ggbeauty989/lcd-deck/anteprima-fronte.png

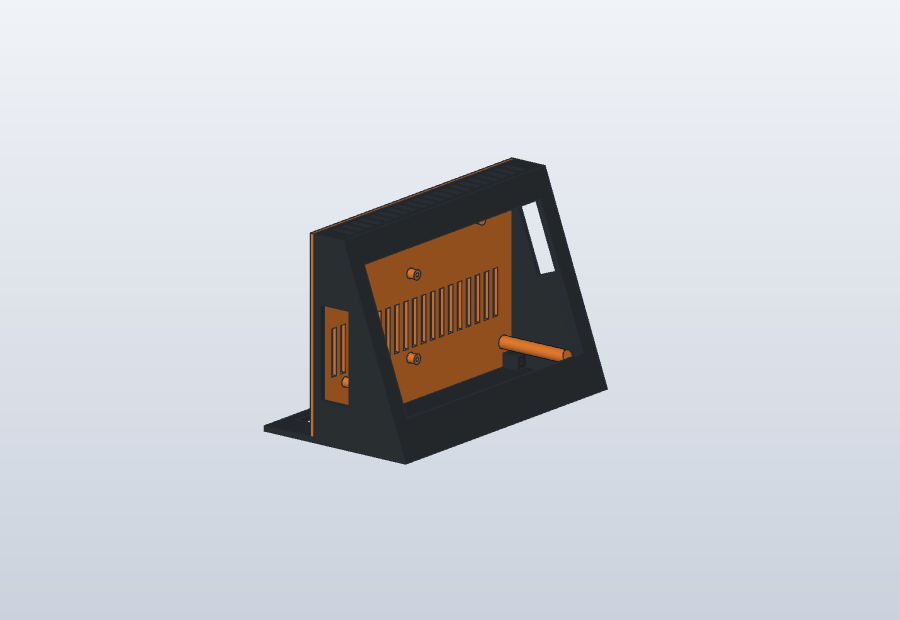
anteprima-fronte.png
