ggbeauty989/lcd-deck/anteprima-retro.png

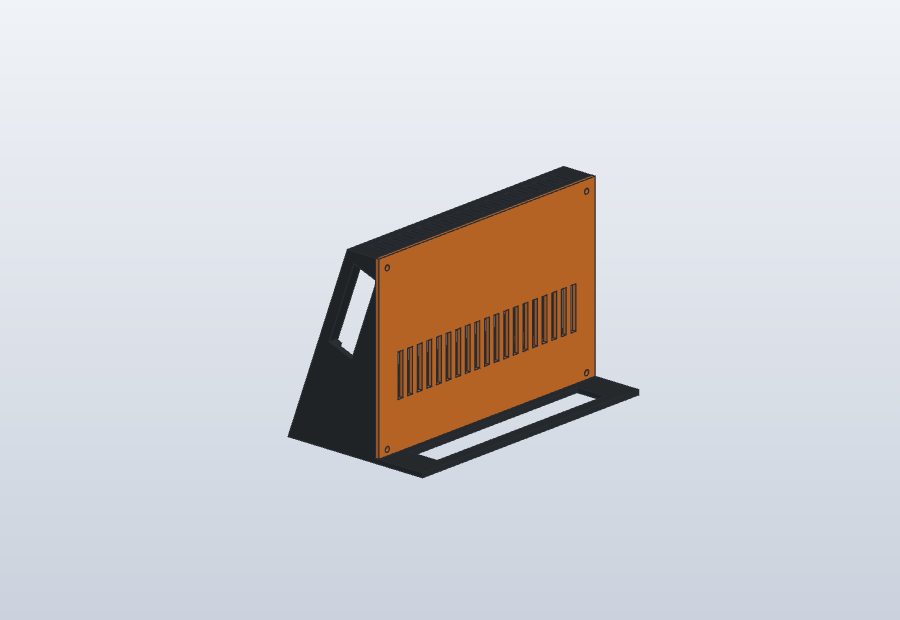
anteprima-retro.png
