ggbeauty989/lcd-deck/anteprima-v2-dettaglio.png

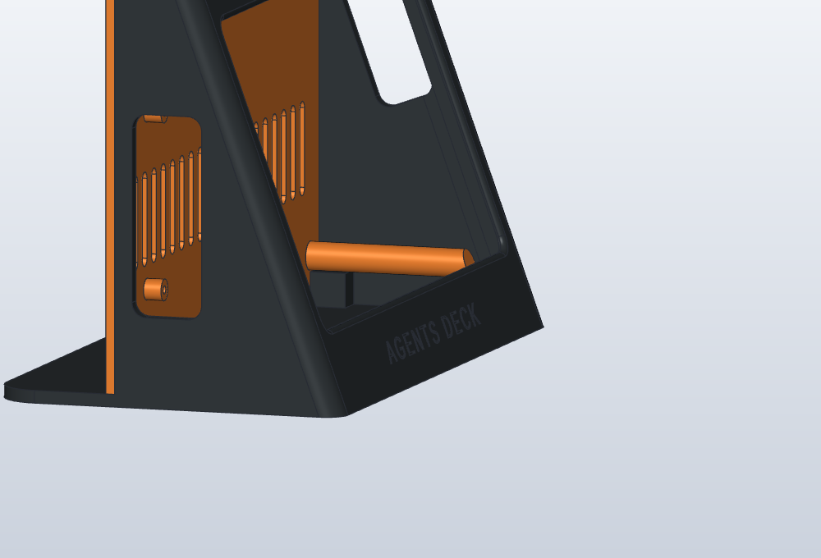
anteprima-v2-dettaglio.png
