ggbeauty989/lcd-deck/anteprima-v3-lato-usb.png

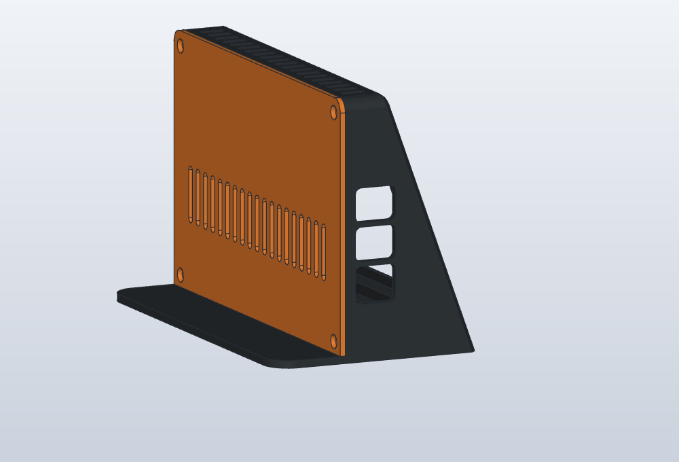
anteprima-v3-lato-usb.png
