ggbeauty989/lcd-deck/screenshot-componenti/02-fianco-sezione.png

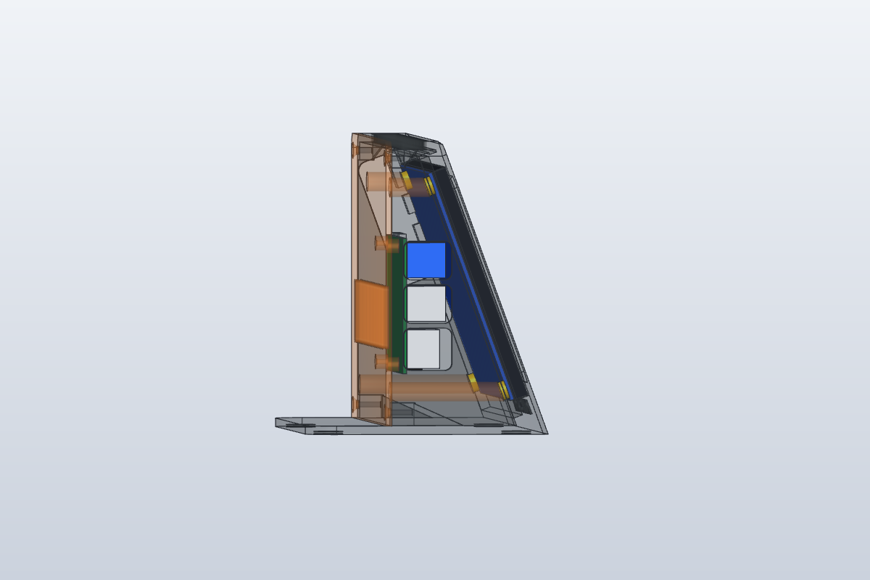
screenshot-componenti/02-fianco-sezione.png
