ggbeauty989/lcd-deck/screenshot-componenti/03-retro-trasparente.png

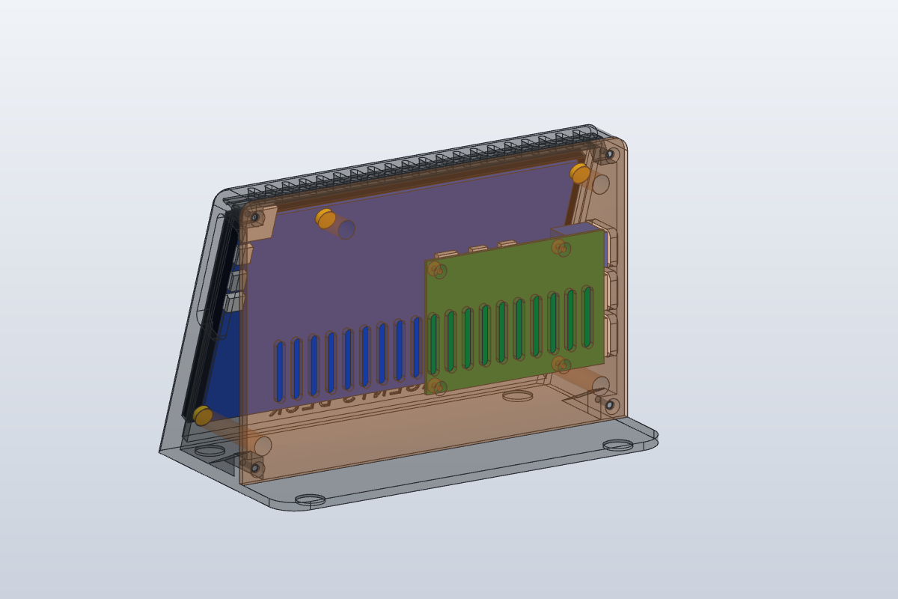
screenshot-componenti/03-retro-trasparente.png
