ggbeauty989/lcd-deck/screenshot-componenti/04-esploso-fronte.png

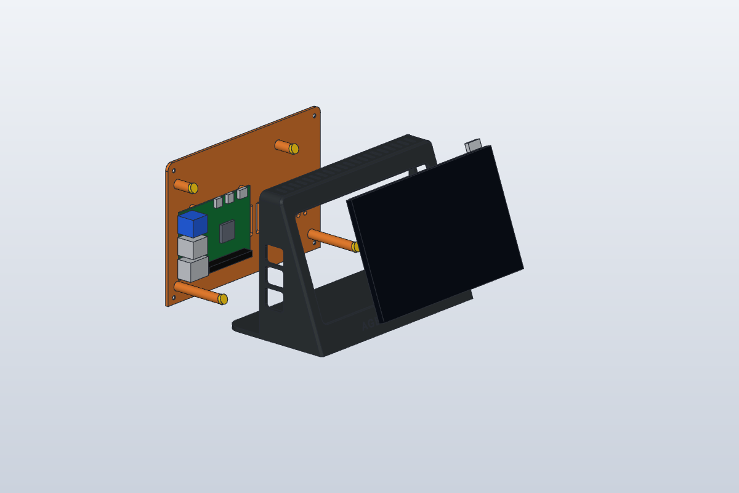
screenshot-componenti/04-esploso-fronte.png
