ggbeauty989/lcd-deck/screenshot-componenti/05-esploso-retro.png

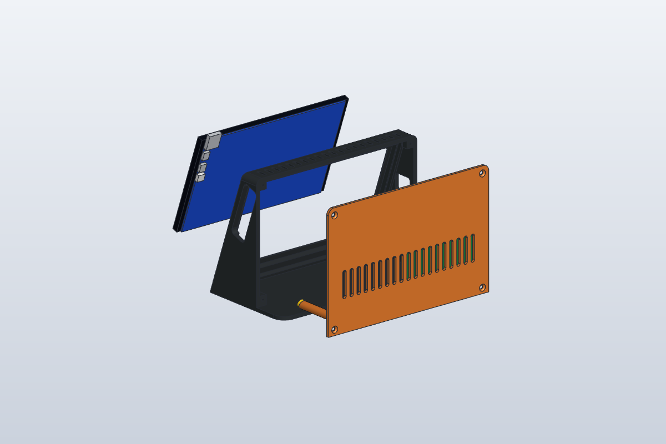
screenshot-componenti/05-esploso-retro.png
