ggbeauty989/lcd-deck/screenshot-modelli-reali/01-montato.png

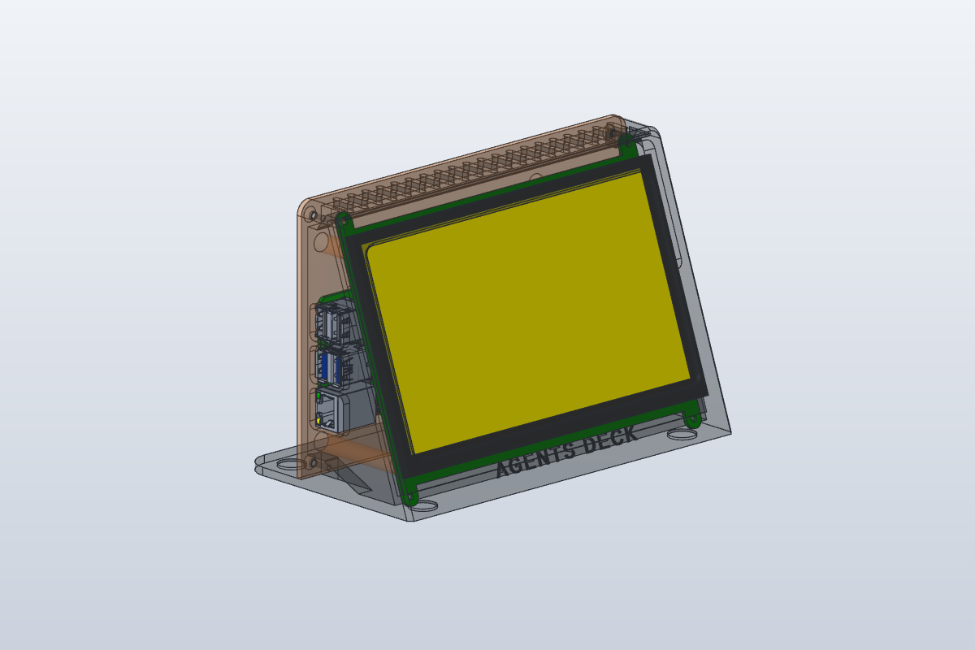
screenshot-modelli-reali/01-montato.png
