ggbeauty989/lcd-deck/screenshot-modelli-reali/03-porte-pi.png

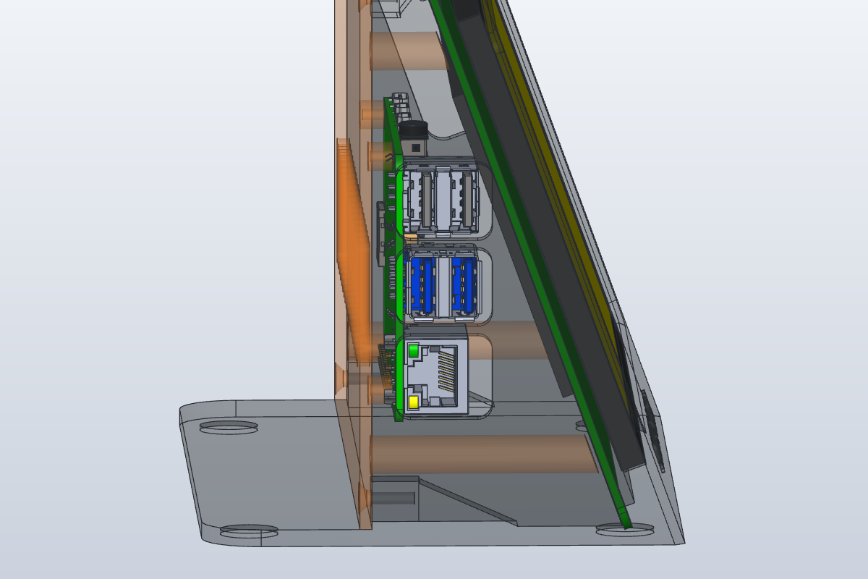
screenshot-modelli-reali/03-porte-pi.png
