ggbeauty989/lcd-deck/screenshot-modelli-reali/05-linguetta-nel-fondo.png

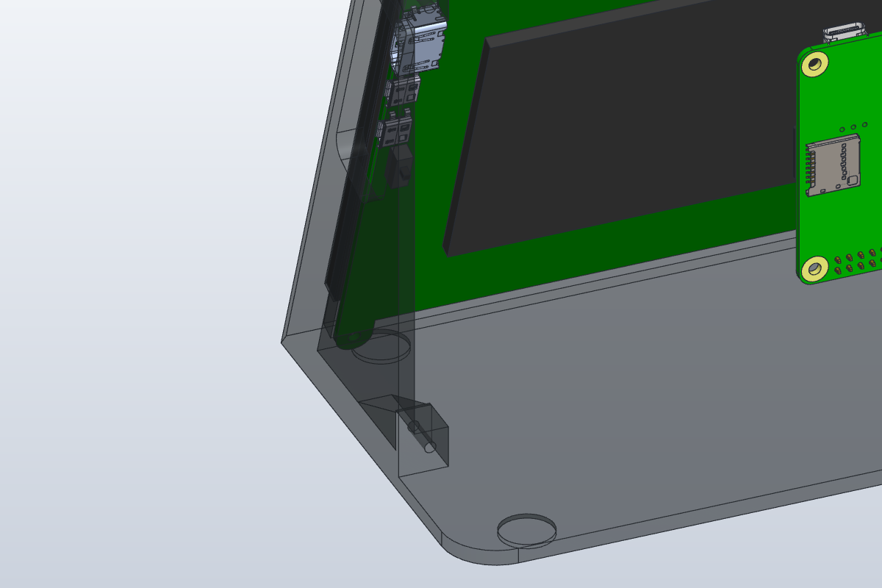
screenshot-modelli-reali/05-linguetta-nel-fondo.png
