ggbeauty989/lcd-deck/deck-v11-assieme.step

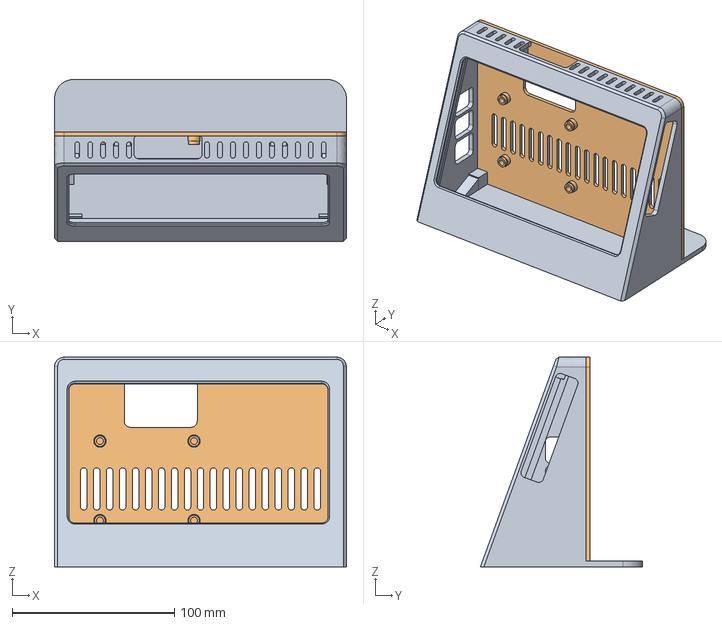
[picture p23: CAD file, 2026-10-25]
deck-v11-assieme.step
180.0 x 100.0 x 129.2 mm
