ggbeauty989/lcd-deck/deck-v11-scocca.stl

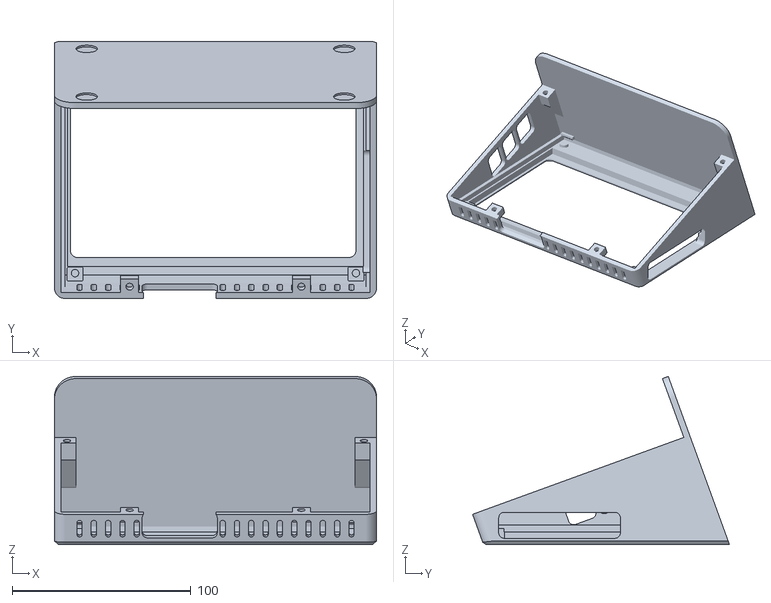
[picture p24: CAD file, 2026-10-25]
deck-v11-scocca.stl
180.0 x 143.6 x 94.0
