ggbeauty989/lcd-deck/deck-v11-coperchio.stl

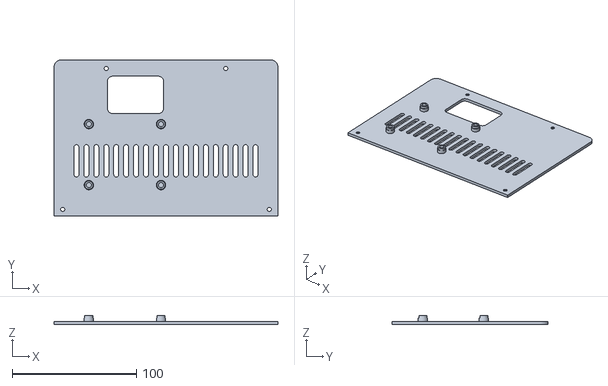
[picture p25: CAD file, 2026-10-25]
deck-v11-coperchio.stl
180.0 x 125.7 x 7.50
