ggbeauty989/lcd-deck/deck-kuman7-pi4-assieme.step

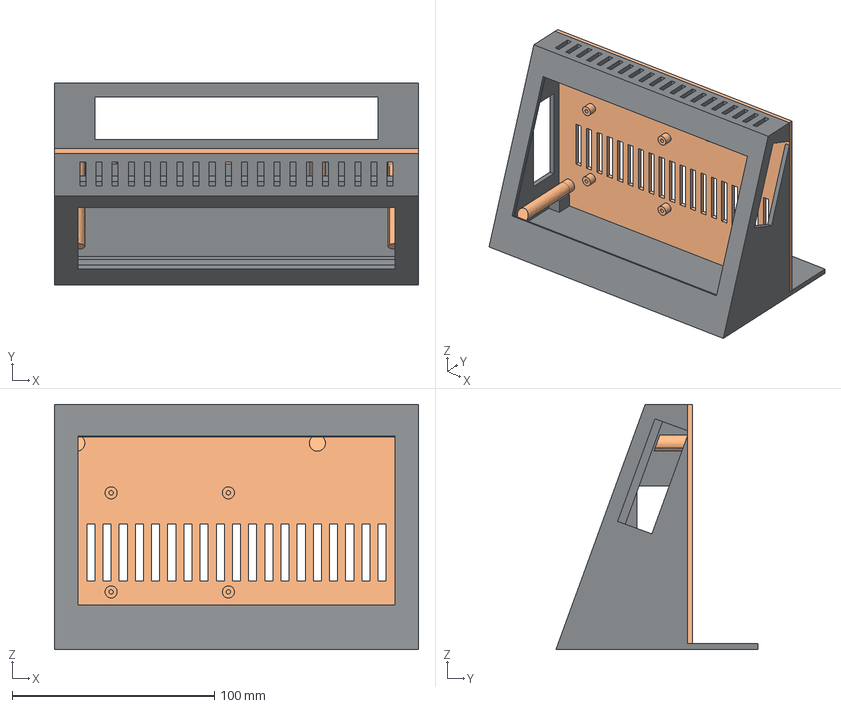
[picture p26: CAD file, 2026-10-24]
deck-kuman7-pi4-assieme.step
180.0 x 100.0 x 121.2 mm
