ggbeauty989/lcd-deck/old/v2/deck-v2-coperchio.stl

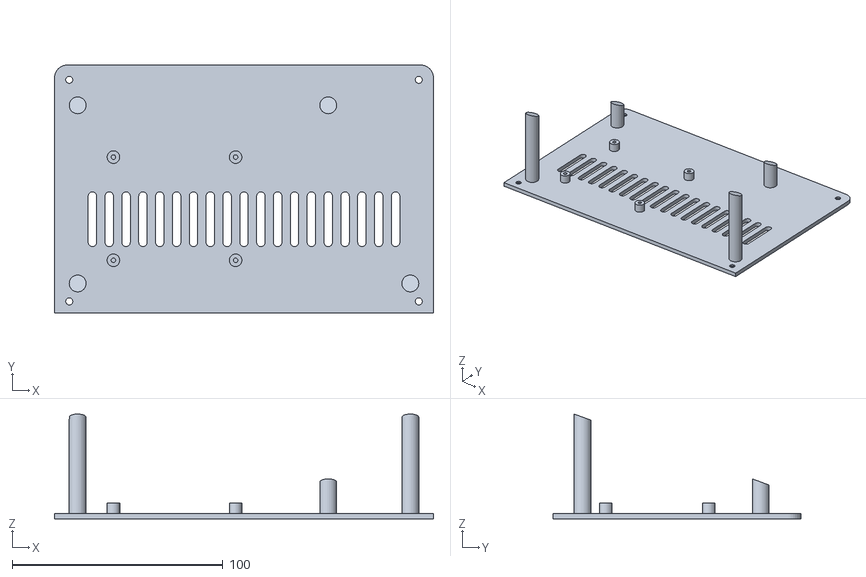
[picture p27: CAD file, 2026-10-24, an earlier design]
old/v2/deck-v2-coperchio.stl
180.0 x 117.7 x 49.8
