ggbeauty989/lcd-deck/old/v3/deck-v3-scocca.stl

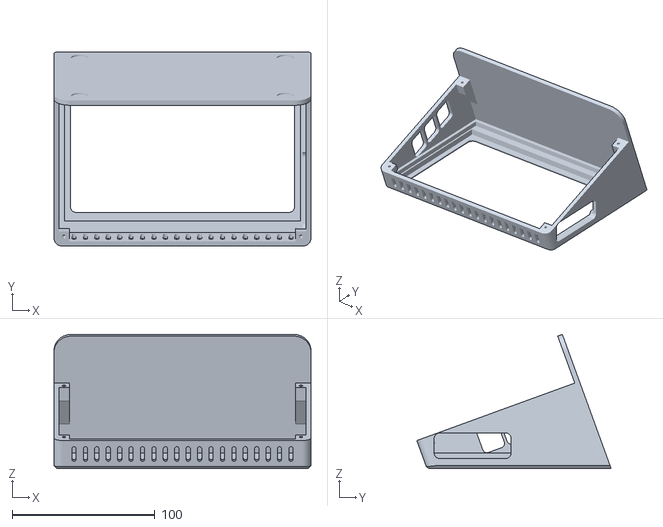
[picture p28: CAD file, 2026-10-24, an earlier design]
old/v3/deck-v3-scocca.stl
180.0 x 136.1 x 94.0
