ggbeauty989/lcd-deck/old/v4/deck-v4-coperchio.stl

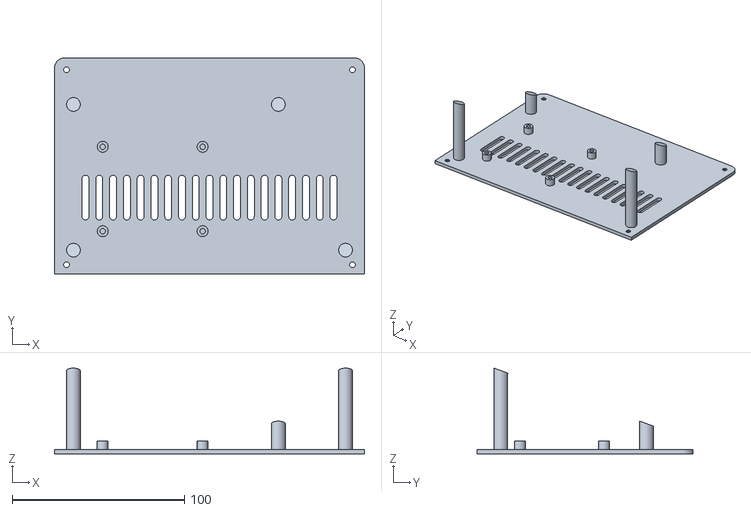
[picture p29: CAD file, 2026-10-24, an earlier design]
old/v4/deck-v4-coperchio.stl
180.0 x 125.7 x 49.8
