ggbeauty989/lcd-deck/old/v5/deck-v5-scocca.stl

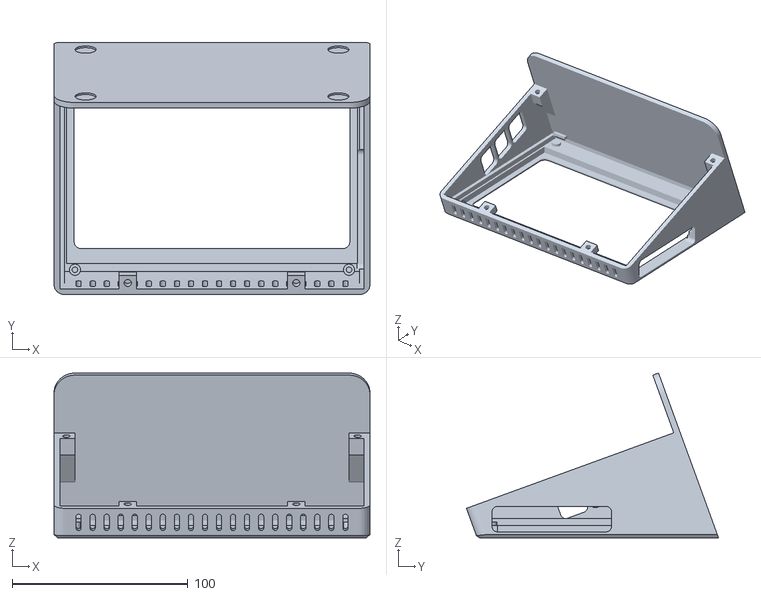
[picture p30: CAD file, 2026-10-24, an earlier design]
old/v5/deck-v5-scocca.stl
180.0 x 143.6 x 94.0
