ggbeauty989/lcd-deck/old/v7/deck-v7-assieme.step

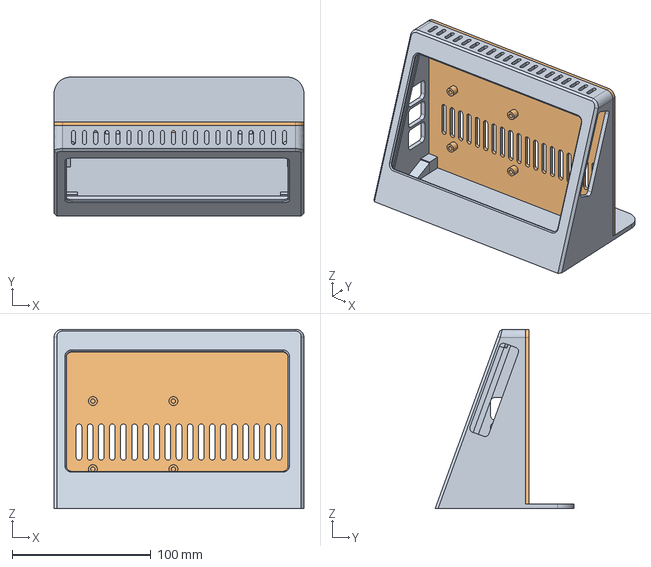
[picture p31: CAD file, 2026-10-25, an earlier design]
old/v7/deck-v7-assieme.step
180.0 x 100.0 x 129.2 mm
