ggbeauty989/lcd-deck/old/v2/deck-v2-assieme.step

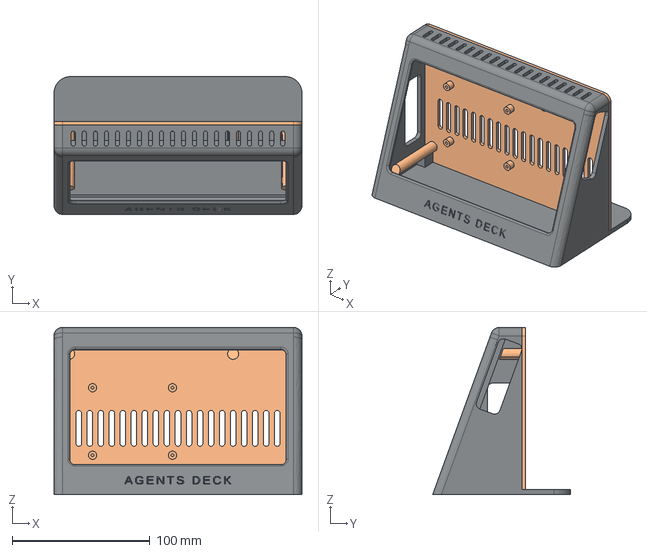
[picture p32: CAD file, 2026-10-24, an earlier design]
old/v2/deck-v2-assieme.step
180.0 x 100.0 x 121.2 mm
