ggbeauty989/lcd-deck/(list of files, cad)

Other CAD files:
old/v6/deck-v6-scocca.stl
old/v8/deck-v8-assieme.step
old/v9/deck-v9-assieme.step
old/v1/deck-coperchio.stl
old/v10/deck-v10-assieme.step
old/v3/deck-v3-assieme.step
deck-coperchio.stl
deck-scocca.stl
deck-v10-assieme.step
deck-v10-scocca.stl
deck-v2-scocca.stl
deck-v3-assieme.step
deck-v3-coperchio.stl
deck-v4-assieme.step
deck-v4-scocca.stl
deck-v5-assieme.step
deck-v6-assieme.step
deck-v6-scocca.stl
deck-v7-coperchio.stl
deck-v7-scocca.stl
deck-v8-assieme.step
deck-v8-coperchio.stl
deck-v9-assieme.step
deck-v9-coperchio.stl
old/v1/deck-scocca.stl
old/v10/deck-v10-scocca.stl
old/v2/deck-v2-scocca.stl
old/v3/deck-v3-coperchio.stl
old/v4/deck-v4-assieme.step
old/v4/deck-v4-scocca.stl
old/v5/deck-v5-assieme.step
old/v6/deck-v6-assieme.step
old/v7/deck-v7-coperchio.stl
old/v7/deck-v7-scocca.stl
old/v8/deck-v8-coperchio.stl
old/v9/deck-v9-coperchio.stl
