ggbeauty989/lcd-deck/(commit log)

2026-10-24 Deck da scrivania per LCD 7" e Raspberry Pi 4
    Supporto stampabile in 3D modellato con SolidCraft: corpo a cuneo
    inclinato di 20 gradi e coperchio posteriore con le colonnine del Pi.
    La v4 e' adattata al circuito con linguette dell'Elecrow/Kuman, ha i
    fori per inserti in ottone M3 e M2.5 e STL verificati a tenuta.
    Inclusi progetti SolidCraft, STEP, immagini e script di costruzione e
    verifica; esclusi i modelli STEP di terzi.
    [deck-coperchio.stl, deck-kuman7-pi4-assieme.step, deck-scocca.stl, deck-v2-assieme.step, deck-v2-coperchio.stl, deck-v2-scocca.stl, deck-v3-assieme.step, deck-v3-coperchio.stl]
2026-10-24 Sposta le versioni v1-v3 in old/
    Ogni versione precedente ha la sua sottocartella (old/v1, old/v2,
    old/v3) e gli script che le hanno costruite stanno in old/script; in
    cima al progetto resta solo la v4. Rimossa la cache di Python finita
    per errore nel primo commit e aggiunta al .gitignore.
    [deck-coperchio.stl, deck-kuman7-pi4-assieme.step, deck-scocca.stl, deck-v2-assieme.step, deck-v2-coperchio.stl, deck-v2-scocca.stl, deck-v3-assieme.step, deck-v3-coperchio.stl]
2026-10-24 v5: deck dimensionato sul display Kuman reale
    Il vano dietro al vetro e l'apertura dei connettori seguono le misure
    prese sul Kuman SC7BC (linguette, fori, HDMI). Lo schermo si fissa con
    due dentini in basso e due viti M2.5 in alto su inserti in ottone; le
    torrette superiori del coperchio sono spostate fuori dal percorso delle
    linguette e il coperchio non ha piu' i pilastrini. Aggiunte le verifiche
    di montaggio e inserimento del display. La v4 passa in old/v4.
    [deck-v4-assieme.step, deck-v4-coperchio.stl, deck-v4-scocca.stl, deck-v5-assieme.step, deck-v5-coperchio.stl, deck-v5-scocca.stl]
2026-10-24 v6: dentini con più gioco e smusso d'invito
    Nella v5 stampata lo schermo non scivolava sotto i dentini: dietro la
    linguetta c'erano solo 0,2 mm, che lo sbalzo stampato annulla. I dentini
    ora stanno 0,6 mm dietro la linguetta, con uno smusso da 0,8 mm sullo
    spigolo d'ingresso. La verifica del display usa lo spessore misurato
    (9 mm) più 0,4 mm di margine di stampa. Coperchio invariato.
    La v5 passa in old/v5, i suoi script in old/script; README aggiornato.
    [deck-v5-assieme.step, deck-v5-coperchio.stl, deck-v5-scocca.stl, deck-v6-assieme.step, deck-v6-coperchio.stl, deck-v6-scocca.stl]
2026-10-24 v6: fori a 157 mm e finestra centrata sull'immagine
    Misure prese sul display: fori delle linguette a 157 mm di interasse in
    orizzontale (prima 156,1), quindi basi, inserti e dentini spostati in
    fuori di 0,45 mm per lato. Il bordo nero del pannello è di 4,75 mm sopra
    e 8,7 mm sotto: la finestra sale di 2 mm per centrare l'immagine.
    Verificata con 0,4 mm di margine di stampa; coperchio invariato.
    [deck-v6-assieme.step, deck-v6-scocca.stl]
2026-10-25 v7: finestra centrata sull'immagine con 2,5 mm di margine
    Nella v6 stampata l'immagine veniva tagliata sul lato opposto all'HDMI:
    in orizzontale non è centrata nel vetro. Bordo nero misurato: 4,75 mm
    sopra, 8,5 sotto, 6,3 sul lato HDMI, 3,45 sul lato opposto. La finestra
    ora segue l'immagine con 2,5 mm di margine (2,25 sul lato opposto
    all'HDMI, per tenere 1,2 mm di vetro sotto la cornice). Dentini, fori e
    coperchio invariati.
    La v6 passa in old/v6, i suoi script in old/script; README aggiornato.
    [deck-v6-assieme.step, deck-v6-coperchio.stl, deck-v6-scocca.stl, deck-v7-assieme.step, deck-v7-coperchio.stl, deck-v7-scocca.stl]
2026-10-25 v8: inserti M3 nelle basi dello schermo
    Le due basi in alto dello schermo, nel corpo, prendono inserti M3 invece
    di M2,5: foro Ø4,2 profondo 5 mm, base rettangolare 9 × 8 mm che comincia
    subito sopra il vetro sollevato durante l'inserimento (1,4 mm di parete
    sotto l'inserto, 2,4 sugli altri lati). Le colonnine del Raspberry Pi
    restano M2,5. Verificata con 0,4 mm di margine di stampa.
    La v7 passa in old/v7, i suoi script in old/script; README aggiornato.
    [deck-v7-assieme.step, deck-v7-coperchio.stl, deck-v7-scocca.stl, deck-v8-assieme.step, deck-v8-coperchio.stl, deck-v8-scocca.stl]
2026-10-25 v9: inserti M3 anche nelle colonnine del Raspberry Pi
    Le colonnine del Pi nel coperchio prendono inserti M3 (foro Ø4,2,
    profondo 5 mm): i fori del Pi vanno allargati a 3,2 mm. Le colonnine
    sono a gradino, Ø7,6 alla base e Ø6,6 negli ultimi 2 mm sotto la scheda,
    dove sporgono le saldature del connettore GPIO: 0,6 mm di spazio misurato
    con il modello ufficiale del Pi 4 (picheck_v9.sh). Corpo uguale alla v8.
    La v8 passa in old/v8, i suoi script in old/script; README aggiornato.
    [deck-v8-assieme.step, deck-v8-coperchio.stl, deck-v8-scocca.stl, deck-v9-assieme.step, deck-v9-coperchio.stl, deck-v9-scocca.stl]
2026-10-25 v10: finestra nel coperchio per i cavi del Raspberry Pi
    I due micro-HDMI e l'USB-C del Pi 4 stanno sul bordo alto della scheda e
    guardano verso il tetto: con il coperchio chiuso la spina non aveva dove
    uscire. Il coperchio ha ora una finestra da 45 × 30 mm sopra quelle tre
    porte: le spine si collegano attraverso la finestra e i cavi escono da
    dietro. Corpo uguale alla v8 e alla v9.
    La v9 passa in old/v9, i suoi script in old/script; README aggiornato con
    l'immagine della finestra e il cavo HDMI da almeno 50 cm.
    [deck-v10-assieme.step, deck-v10-coperchio.stl, deck-v10-scocca.stl, deck-v9-assieme.step, deck-v9-coperchio.stl, deck-v9-scocca.stl]
2026-10-25 v11: foro nel tetto per i cavi del Raspberry Pi
    Stampata, la spina micro-HDMI e il pressacavo (circa 35 mm) sono più
    lunghi della finestra del coperchio e il cavo piegava troppo stretto.
    Il corpo ha ora un foro da 42 × 14 mm nella griglia del tetto, sopra
    l'HDMI0 e l'USB-C, aperto verso il bordo posteriore (lo chiude il
    coperchio): i cavi escono dritti verso l'alto. Coperchio uguale alla v10.
    La v10 passa in old/v10, i suoi script in old/script; README aggiornato.
    [deck-v10-assieme.step, deck-v10-coperchio.stl, deck-v10-scocca.stl, deck-v11-assieme.step, deck-v11-coperchio.stl, deck-v11-scocca.stl]
